lanq21/auto_knob/README.md

# Auto_knob

---

## 提交日志：

### 2023 / 5 / 9

* 创建项目

### 2023 / 5/ 23

* 板子画了 `5/8`
* 优化了 `O(1)` 找最近点的多档开关
* 手感：太丝滑了

### 2023 / 5 / 31

* 计划的功能（旋钮控制电脑部分）：调节音量，模拟按键，模拟滚轮
* 来点串口接收

### 2023 / 6 / 6

* 完成辣！
