lanq21/auto_knob/Core/Src/main.c

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
/* Includes ------------------------------------------------------------------*/
#include "main.h"
#include "adc.h"
#include "dma.h"
#include "spi.h"
#include "tim.h"
#include "usart.h"
#include "gpio.h"

/* USER CODE BEGIN Includes */
#include "knob.h"
/* USER CODE END Includes */


void SystemClock_Config(void);
/**
 * @brief  The application entry point.
 * @retval int
 */
int main(void)
{
    /* MCU Configuration--------------------------------------------------------*/

    /* Reset of all peripherals, Initializes the Flash interface and the Systick. */
    HAL_Init();

    /* Configure the system clock */
    SystemClock_Config();

    /* Initialize all configured peripherals */
    MX_GPIO_Init();
    MX_DMA_Init();
    MX_SPI1_Init();
    MX_ADC1_Init();
    MX_TIM2_Init();
    MX_TIM3_Init();
    MX_USART1_UART_Init();
    MX_SPI2_Init();
    /* USER CODE BEGIN 2 */

    Knob_Init();

    /* USER CODE END 2 */

    /* Infinite loop */
    /* USER CODE BEGIN WHILE */
    uint32_t count = 0;
    while (1)
    {
        /* USER CODE END WHILE */

        /* USER CODE BEGIN 3 */
        u1_printf("%f,%f\n", Motor_Current_Angle, Motor_Current_Speed);
        Knob_Draw();
    }
    /* USER CODE END 3 */
}

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
/* USER CODE BEGIN 4 */
void HAL_TIM_PeriodElapsedCallback(TIM_HandleTypeDef *htim)
{
    if (htim->Instance == TIM2)
    {
        Knob_TIM();
        Motor_TIM();
    }
}

void HAL_UARTEx_RxEventCallback(UART_HandleTypeDef *huart, uint16_t Size)
{
    if (huart->Instance == USART1)
    {
        Knob_UART();
    }
}
/* USER CODE END 4 */
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
