lanq21/auto_knob/auto_knob.ioc

Mcu.UserName=STM32F103RCTx
PA0-WKUP.Signal=ADCx_IN0
PA10.Signal=USART1_RX
PA4.GPIO_Label=SPI3CS
PA4.Signal=GPIO_Output
PA5.Signal=SPI1_SCK
PA6.Signal=SPI1_MISO
PA7.Signal=SPI1_MOSI
PA9.Signal=USART1_TX
PB13.Signal=SPI2_SCK
PB14.Signal=SPI2_MISO
PB15.Signal=SPI2_MOSI
PC0.GPIO_Label=BLK
PC0.Signal=GPIO_Output
PC1.GPIO_Label=CS
PC1.Signal=GPIO_Output
PC2.GPIO_Label=DC
PC2.Signal=GPIO_Output
PC3.GPIO_Label=RES
PC3.Signal=GPIO_Output
PC6.Signal=S_TIM3_CH1
PC7.Signal=S_TIM3_CH2
PC8.Signal=S_TIM3_CH3
PC9.Signal=GPIO_Output
PD0-OSC_IN.Signal=RCC_OSC_IN
PD1-OSC_OUT.Signal=RCC_OSC_OUT
