lanq21/auto_knob/Core/Inc/main.h

#define BLK_Pin GPIO_PIN_0
#define BLK_GPIO_Port GPIOC
#define CS_Pin GPIO_PIN_1
#define CS_GPIO_Port GPIOC
#define DC_Pin GPIO_PIN_2
#define DC_GPIO_Port GPIOC
#define RES_Pin GPIO_PIN_3
#define RES_GPIO_Port GPIOC
#define SPI3CS_Pin GPIO_PIN_4
#define SPI3CS_GPIO_Port GPIOA
