lanq21/auto_knob/(commit log)

2023-05-23 下一步：画板子
2023-05-31 来点串口接收
2023-06-05 完成辣！
2023-06-06 加入测试文件
2023-06-06 加入展示PPT
2023-06-22 加入技术报告
